Bmcneley/2027Payload/README.md

# 2027Payload
KiCad project files for 2027 Cy Launch payload PCB.
