Bmcneley/2027Payload/2027Payload.csv

Reference | Qty | Value | DNP | Exclude from BOM | Exclude from Board | Footprint | Manufacturer Part Number | Distributor Link
U12 | 1 | BMP581 |  |  |  | BMP581:BMP581 | BMP581 | https://www.digikey.com/en/products/detail/bosch-sensortec/BMP581/16036134
U11 | 1 | SAM-M10Q-00B |  |  |  | SAM-M10Q-00B:XCVR_SAM-M10Q-00B | SAM-M10Q-00B | https://www.digikey.com/en/products/detail/u-blox/SAM-M10Q-00B/16672678
U9 | 1 | TPS2113ADRBR |  |  |  | TPS2113ADRBR:SON65P300X300X100-9N | TPS2113ADRBR | https://www.digikey.com/en/products/detail/texas-instruments/TPS2113ADRBR/2353703
U7 | 1 | TLV75533PDBVR |  |  |  | TLV75533PDBVR:SOT95P280X145-5N | TLV75533PDBVR | https://www.digikey.com/en/products/detail/texas-instruments/TLV75533PDBVR/9356541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
U6 | 1 | USBLC6-2SC6 |  |  |  | Package_TO_SOT_SMD:SOT-23-6 | USBLC6-2SC6 | https://www.digikey.com/en/products/detail/stmicroelectronics/USBLC6-2SC6/1040559
U5 | 1 | BNO055 |  |  |  | BNO055:LGA28R50P4X10_380X520X100 | BNO055 | https://www.digikey.com/en/products/detail/bosch-sensortec/BNO055/6136301
U3 | 1 | TPS22965DSGT |  |  |  | TPS22965DSGT:SON50P200X200X80-9N | TPS22965DSGT | https://www.digikey.com/en/products/detail/texas-instruments/TPS22965DSGT/3661875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
U2 | 1 | TPS543620RPYR |  |  |  | TPS543620RPYR:IC_TPS543620RPYR | TPS543620RPYR | https://www.digikey.com/en/products/detail/texas-instruments/TPS543620RPYR/13563030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
U1 | 1 | ESP32-S3-WROOM-1-N8R8 |  |  |  | ESP32-S3-WROOM-1-N8R8:XCVR_ESP32S3WROOM1N8R8 | ESP32-S3-WROOM-1-N8R8 | https://www.digikey.com/en/products/detail/espressif-systems/ESP32-S3-WROOM-1-N8R8/15295891
SW1,SW2 | 2 | SW_Push |  |  |  | Button_Switch_SMD:SW_SPST_PTS645Sx43SMTR92 | PTS645SM43SMTR92 LFS | https://www.digikey.com/en/products/detail/c-k/PTS645SM43SMTR92-LFS/1146840
R34 | 1 | 90.9k |  |  |  | Resistor_SMD:R_0603_1608Metric | CR0603-FX-9092ELF | https://www.digikey.com/en/products/detail/bourns-inc/CR0603-FX-9092ELF/3784211
R31 | 1 | 300R |  |  |  | Resistor_SMD:R_0603_1608Metric | ERJ-3GEYJ301V | https://www.digikey.com/en/products/detail/panasonic-industry/ERJ-3GEYJ301V/29175
R30,R32,R33,R37 | 4 | 330R |  |  |  | Resistor_SMD:R_0603_1608Metric | RC0603FR-07330RL | https://www.digikey.com/en/products/detail/yageo/RC0603FR-07330RL/727162
R26 | 1 | 24.3k |  |  |  | Resistor_SMD:R_0603_1608Metric | RC0603FR-0724K3L | https://www.digikey.com/en/products/detail/yageo/RC0603FR-0724K3L/727078
R25 | 1 | 11.3k |  |  |  | Resistor_SMD:R_0603_1608Metric | RT0603BRD0711K3L | https://www.digikey.com/en/products/detail/yageo/RT0603BRD0711K3L/1072211
R23 | 1 | 43k |  |  |  | Resistor_SMD:R_0603_1608Metric | RC0603JR-0743KL | https://www.digikey.com/en/products/detail/yageo/RC0603JR-0743KL/726790
R21,R22,R36 | 3 | 100k |  |  |  | Resistor_SMD:R_0603_1608Metric | RC0603FR-07100KL | https://www.digikey.com/en/products/detail/yageo/RC0603FR-07100KL/726889
R16 | 1 | 91k |  |  |  | Resistor_SMD:R_0603_1608Metric | RC0603JR-0791KL | https://www.digikey.com/en/products/detail/yageo/RC0603JR-0791KL/726841
R15 | 1 | 332R |  |  |  | Resistor_SMD:R_0603_1608Metric | CR0603-FX-3320ELF | https://www.digikey.com/en/products/detail/bourns-inc/CR0603-FX-3320ELF/3783952
R10 | 1 | 100R |  |  |  | Resistor_SMD:R_0603_1608Metric | RC0603FR-07100RL | https://www.digikey.com/en/products/detail/yageo/RC0603FR-07100RL/726888
R9,R24,R27,R28,R29,R35,R38,R39,R40 | 9 | 10k |  |  |  | Resistor_SMD:R_0603_1608Metric | RC0603JR-0710KL | https://www.digikey.com/en/products/detail/yageo/RC0603JR-0710KL/726700
R7,R8 | 2 | 5.1K |  |  |  | Resistor_SMD:R_0603_1608Metric | AC0603FR-135K1L | https://www.digikey.com/en/products/detail/yageo/AC0603FR-135K1L/14008356
Q2 | 1 | AO4407A |  |  |  | AO4407A (1):SOIC127P600X175-8N | AO4407A | https://www.digikey.com/en/products/detail/alpha-omega-semiconductor-inc/AO4407A/1855794
L1 | 1 | 2.4uH |  |  |  | 744325240:WE-HCI_1050 | 744325240 | https://www.digikey.com/en/products/detail/w%C3%BCrth-elektronik/744325240/1638573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
J11 | 1 | Conn_01x03 |  |  |  | Connector_JST:JST_PH_S3B-PH-K_1x03_P2.00mm_Horizontal | B3B-PH-SM4-TBT | https://www.digikey.com/en/products/detail/jst-sales-america-inc/B3B-PH-SM4-TBT/768445?gclsrc=aw.ds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
J10 | 1 | Conn_02x03_Odd_Even |  |  |  | Connector_PinHeader_2.54mm:PinHeader_2x03_P2.54mm_Vertical | PRPC003DAAN-RC | https://www.digikey.com/en/products/detail/sullins-connector-solutions/PRPC003DAAN-RC/2775291
J8 | 1 | Conn_01x04 |  |  |  | Connector_JST:JST_PH_S4B-PH-K_1x04_P2.00mm_Horizontal | 2mm 4-pin Horizontal Connector - JST PH Compatible - 10 Pack - STEMMA | https://www.adafruit.com/product/4392
J6,J7 | 2 | Conn_01x04 |  |  |  | Connector_JST:JST_SH_SM04B-SRSS-TB_1x04-1MP_P1.00mm_Horizontal | QWIIC/STEMMAQT Connector 2mm 4pin | https://www.adafruit.com/product/4392
J3,J4,J5,J12 | 4 | Conn_01x03 |  |  |  | Connector_PinHeader_2.54mm:PinHeader_1x03_P2.54mm_Vertical | M20-9990345 | https://www.digikey.com/en/products/detail/harwin-inc/M20-9990345/3728227
J1 | 1 | USB_C_Receptacle_USB2.0_16P |  |  |  | Connector_USB:USB_C_Receptacle_GCT_USB4110 | USB4110-GF-A | https://www.digikey.com/en/products/detail/gct/USB4110-GF-A/10384547
F1 | 1 | 5A |  |  |  | Fuse:Fuse_1812_4532Metric | 0448005.MR | https://www.digikey.com/en/products/detail/littelfuse-inc/0448005-MR/1211090
D2 | 1 | 10V |  |  |  | Diode_SMD:D_SOD-123 | MMSZ5240B-7-F | https://www.digikey.com/en/products/detail/diodes-incorporated/MMSZ5240B-7-F/815879
D1 | 1 | LED |  |  |  | LED_SMD:LED_0805_2012Metric | 150080RS75000 | https://www.digikey.com/en/products/detail/w-rth-elektronik/150080RS75000/4489918?gclsrc=aw.ds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
C46 | 1 | 10n |  |  |  | Capacitor_SMD:C_0603_1608Metric | C0603C103K5RACTU | https://www.digikey.com/en/products/detail/kemet/C0603C103K5RACTU/411090
C40,C41,C44 | 3 | 22u |  |  |  | Capacitor_SMD:C_0603_1608Metric | CL10A226MO7JZNC | https://www.digikey.com/en/products/detail/samsung-electro-mechanics/CL10A226MO7JZNC/7320581
C36,C39 | 2 | 47u |  |  |  | Capacitor_SMD:C_0603_1608Metric | GRM188R60J476ME15D | https://www.digikey.com/en/products/detail/murata-electronics/GRM188R60J476ME15D/5877410
C35 | 1 | 15p |  |  |  | Capacitor_SMD:C_0603_1608Metric | CC0603JRNPO9BN150 | https://www.digikey.com/en/products/detail/yageo/CC0603JRNPO9BN150/302794
C30,C32,C33,C37,C38 | 5 | 4.7u |  |  |  | Capacitor_SMD:C_0603_1608Metric | GRM188R61E475KE11D | https://www.digikey.com/en/products/detail/murata-electronics/GRM188R61E475KE11D/3900465
C22,C42,C43,C45 | 4 | 0.1u |  |  |  | Capacitor_SMD:C_0603_1608Metric | C0603C104K5RACTU | https://www.digikey.com/en/products/detail/kemet/C0603C104K5RACTU/1465594
C18,C23,C24,C25,C26,C28,C31,C34,C47,C48,C49 | 11 | 100n |  |  |  | Capacitor_SMD:C_0603_1608Metric | C0603C104K5RACTU | https://www.digikey.com/en/products/detail/kemet/C0603C104K5RACTU/1465594
C12,C13,C15,C16,C17 | 5 | 1u |  |  |  | Capacitor_SMD:C_0603_1608Metric | UMK107AB7105KA-T | https://www.digikey.com/en/products/detail/taiyo-yuden/UMK107AB7105KA-T/3660085
C5,C14,C27,C29 | 4 | 10u |  |  |  | Capacitor_SMD:C_0603_1608Metric | GRM188R61E106MA73D | https://www.digikey.com/en/products/detail/murata-electronics/GRM188R61E106MA73D/3900497
C2 | 1 | 470u |  |  |  | Capacitor_SMD:CP_Elec_10x10 | MAL215097501E3 | https://www.digikey.com/en/products/detail/vishay-beyschlag-draloric-bc-components/MAL215097501E3/5635420
