Bmcneley/2027Payload/2027Payload.pdf

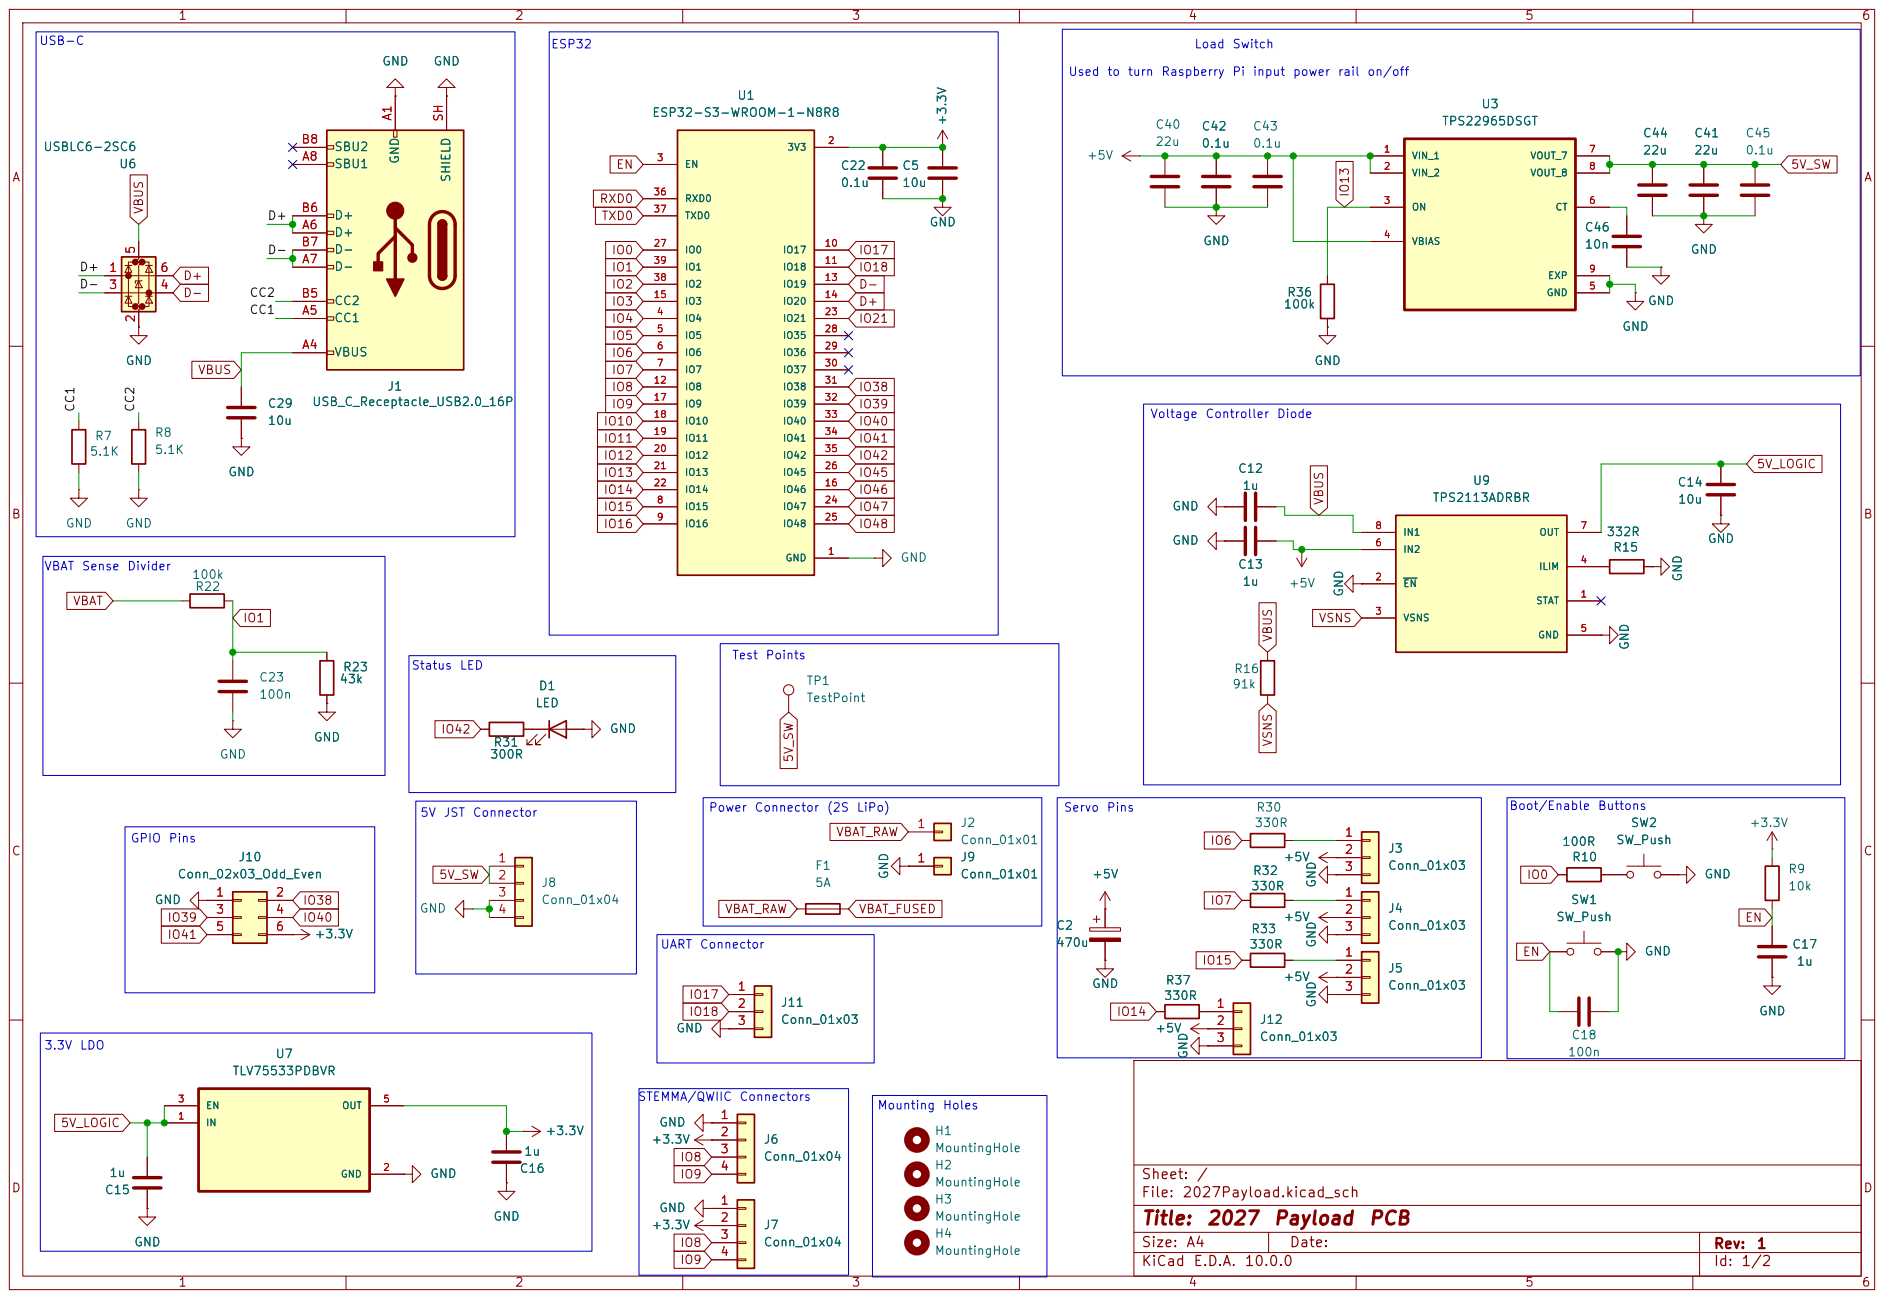
[picture p1: page 1]

Load Switch Used to turn Raspberry Pi input power rail on/off

SW_Push GND
VBAT Sense Divider GND

Boot/Enable Buttons 3.3V LDO

Size: A4 | Rev: 1
KiCad E.D.A. 10.0.0 | Id: 1/2

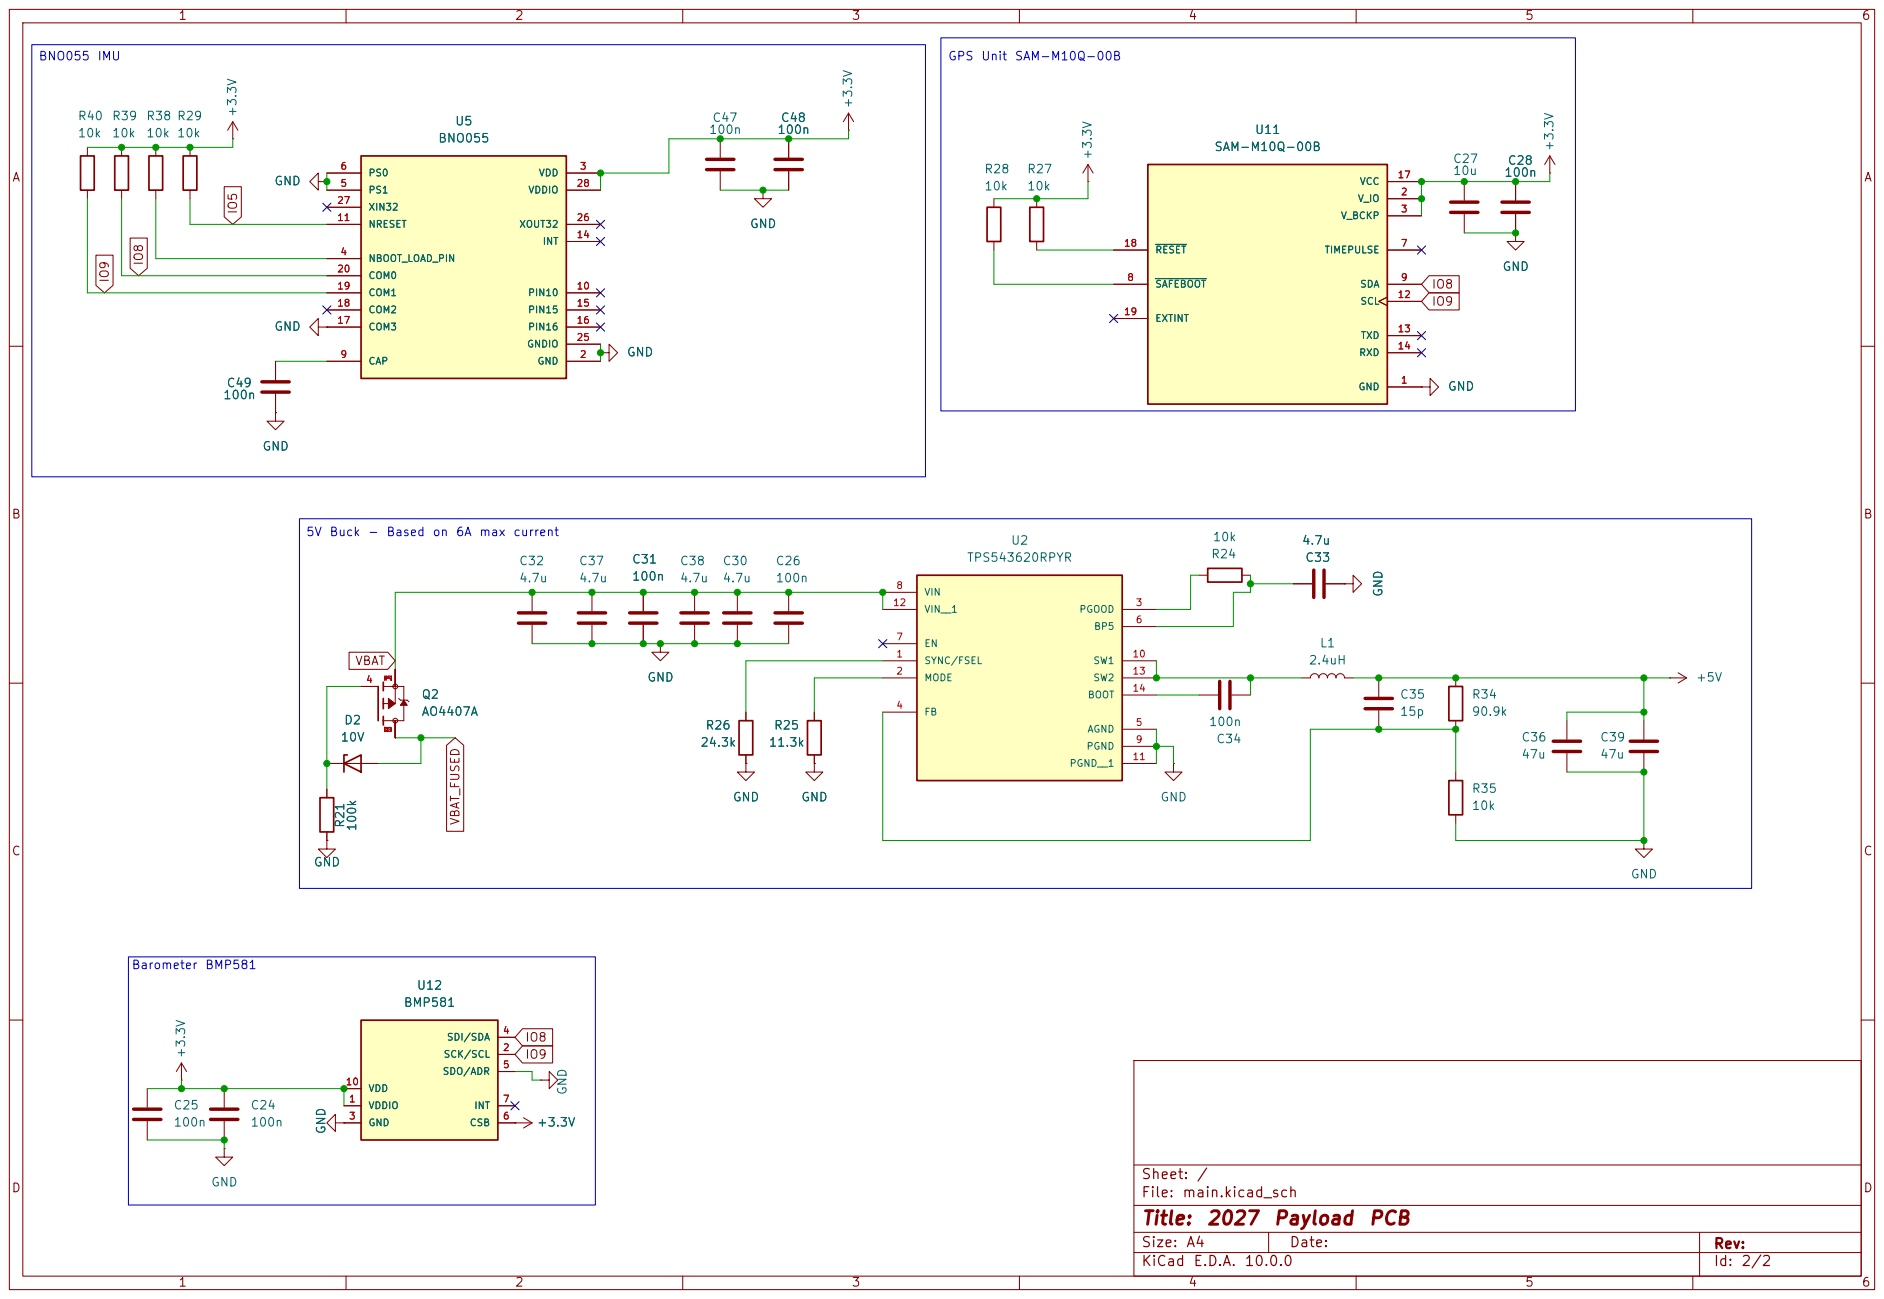
[picture p2: page 2]

Barometer BMP581

100n C25 | VDDIO 1

Size: A4 | Rev:
KiCad E.D.A. 10.0.0 | Id: 2/2
