Bmcneley/2027Payload/2027Payload.kicad_pcb

## KiCad design 2027Payload.kicad_pcb (2026-09-01)

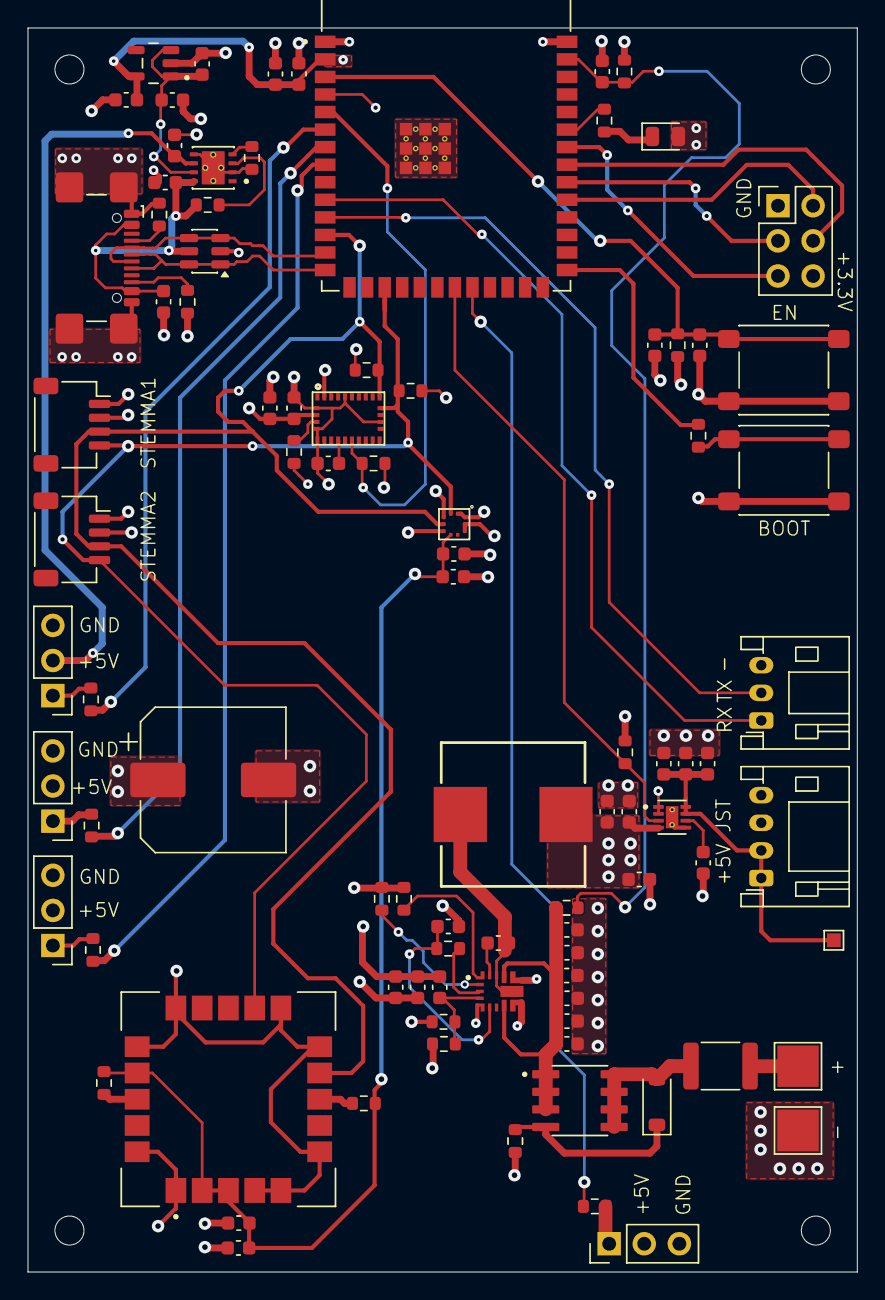
[picture p3: board 2027Payload.kicad_pcb from above]

Board: 4 copper layers, 60.0 x 90.0 mm, 96 parts (0 on the bottom side), 52 nets.

Parts:
C2: 470u; CP_Elec_10x10
C5, C14, C27, C29: 10u; C_0603_1608Metric
C12, C13, C15, C16, C17: 1u; C_0603_1608Metric
C18, C23, C24, C25, C26, C28, C31, C34, C47, C48, C49: 100n; C_0603_1608Metric
C22, C42, C43, C45: 0.1u; C_0603_1608Metric
C30, C32, C33, C37, C38: 4.7u; C_0603_1608Metric
C35: 15p; C_0603_1608Metric
C36, C39: 47u; C_0603_1608Metric
C40, C41, C44: 22u; C_0603_1608Metric
C46: 10n; C_0603_1608Metric
D1: LED; LED_0805_2012Metric
D2: 10V; D_SOD-123
F1: 5A; Fuse_1812_4532Metric
H1, H2, H3, H4: MountingHole; MountingHole_2.1mm
J1: USB_C_Receptacle_USB2.0_16P; USB_C_Receptacle_GCT_USB4110
J2, J9: Conn_01x01; TestPoint_Pad_3.0x3.0mm
J3, J4, J5, J12: Conn_01x03; PinHeader_1x03_P2.54mm_Vertical
J6, J7: Conn_01x04; JST_SH_SM04B-SRSS-TB_1x04-1MP_P1.00mm_Horizontal
J8: Conn_01x04; JST_PH_S4B-PH-K_1x04_P2.00mm_Horizontal
J10: Conn_02x03_Odd_Even; PinHeader_2x03_P2.54mm_Vertical
J11: Conn_01x03; JST_PH_S3B-PH-K_1x03_P2.00mm_Horizontal
L1: 2.4uH; WE-HCI_1050
Q2: AO4407A; SOIC127P600X175-8N
R7, R8: 5.1K; R_0603_1608Metric
R9, R24, R27, R28, R29, R35, R38, R39, R40: 10k; R_0603_1608Metric
R10: 100R; R_0603_1608Metric
R15: 332R; R_0603_1608Metric
R16: 91k; R_0603_1608Metric
R21, R22, R36: 100k; R_0603_1608Metric
R23: 43k; R_0603_1608Metric
R25: 11.3k; R_0603_1608Metric
R26: 24.3k; R_0603_1608Metric
R30, R32, R33, R37: 330R; R_0603_1608Metric
R31: 300R; R_0603_1608Metric
R34: 90.9k; R_0603_1608Metric
SW1, SW2: SW_Push; SW_SPST_PTS645Sx43SMTR92
TP1: TestPoint; TestPoint_Pad_1.0x1.0mm
U1: ESP32-S3-WROOM-1-N8R8; XCVR_ESP32S3WROOM1N8R8
U2: TPS543620RPYR; IC_TPS543620RPYR
U3: TPS22965DSGT; SON50P200X200X80-9N
U5: BNO055; LGA28R50P4X10_380X520X100
U6: USBLC6-2SC6; SOT-23-6
U7: TLV75533PDBVR; SOT95P280X145-5N
U9: TPS2113ADRBR; SON65P300X300X100-9N
U11: SAM-M10Q-00B; XCVR_SAM-M10Q-00B
U12: BMP581

Connections:
5V_LOGIC: C14.1, C15.2, U7.1 (IN), U7.3 (EN), U9.7 (OUT)
5V_SW: C41.1, C44.1, C45.1, J8.1, J8.2, TP1.1 (1_1), U3.7 (VOUT_7), U3.8 (VOUT_8)
+3.3V: C5.1, C16.2, C22.1, C24.1, C25.1, C27.1, C28.1, C47.1, C48.1, J6.2, J7.2, J10.6, R9.1, R27.1, R28.1, R29.1, R38.1, R39.1, R40.1, U1.2 (3V3), U5.3 (VDD), U5.28 (VDDIO), U7.5 (OUT), U11.2 (V_IO), U11.3 (V_BCKP), U11.17 (VCC), U12.1 (VDDIO), U12.6 (CSB), U12.10 (VDD)
+5V: C2.1, C13.1, C35.2, C36.2, C39.2, C40.1, C42.1, C43.1, J3.2, J4.2, J5.2, J12.2, L1.2, R34.2, U3.1 (VIN_1), U3.2 (VIN_2), U3.4 (VBIAS), U9.6 (IN2)
/CC1: J1.A5 (CC1), R7.1
/CC2: J1.B5 (CC2), R8.1
D+: J1.A6 (D+), J1.B6 (D+), U1.14 (IO20), U6.1 (I/O1), U6.6 (I/O1)
D-: J1.A7 (D-), J1.B7 (D-), U1.13 (IO19), U6.3 (I/O2), U6.4 (I/O2)
EN: C17.2, C18.1, R9.2, SW1.1, U1.3 (EN)
GND: C2.2, C5.2, C12.1, C13.2, C14.2, C15.1, C16.1, C17.1, C18.2, C22.2, C23.2, C24.2, C25.2, C26.2, C27.2, C28.2, C29.2, C30.2, C31.2, C32.2, C33.2, C36.1, C37.2, C38.2, C39.1, C40.2, C41.2, C42.2, C43.2, C44.2, C45.2, C46.2, C47.2, C48.2, C49.2, D1.2 (A), J1.A1 (GND), J1.A12 (GND), J1.B1 (GND), J1.B12 (GND), J1.SH (SHIELD), J3.3, J4.3, J5.3, J6.1, J7.1, J8.3, J8.4, J9.1 (Pin_1_1), J10.1, J11.3, J12.3, R7.2, R8.2, R15.2, R21.2, R23.1, R25.2, R26.2, R35.1, R36.1, SW1.2, SW2.2, U1.1 (GND), U1.40 (GND), U1.41_1 (GND), U1.41_2 (GND), U1.41_3 (GND), U1.41_4 (GND), U1.41_5 (GND), U1.41_6 (GND), U1.41_7 (GND), U1.41_8 (GND), U1.41_9 (GND), U2.5 (AGND), U2.9 (PGND), U2.11 (PGND__1), U3.5 (GND), U3.9 (EXP), U5.2 (GND), U5.5 (PS1), U5.6 (PS0), U5.17 (COM3), U5.25 (GNDIO), U6.2 (GND), U7.2 (GND), U9.2 (~EN), U9.5 (GND), U9.9 (GND), U11.1 (GND), U11.4 (GND), U11.5 (GND), U11.6 (GND), U11.10 (GND), U11.11 (GND), U11.15 (GND), U11.16 (GND), U11.20 (GND), U12.3 (GND), U12.5 (SDO/ADR), U12.8 (GND), U12.9 (GND)
IO0: R10.2, U1.27 (IO0)
IO1: C23.1, R22.2, R23.2, U1.39 (IO1)
IO5: R29.2, U1.5 (IO5), U5.11 (NRESET)
IO6: R30.2, U1.6 (IO6)
IO7: R32.2, U1.7 (IO7)
IO8: J6.3, J7.3, R39.2, U1.12 (IO8), U5.20 (COM0), U11.9 (SDA), U12.4 (SDI/SDA)
IO9: J6.4, J7.4, R40.2, U1.17 (IO9), U5.19 (COM1), U11.12 (SCL), U12.2 (SCK/SCL)
IO13: R36.2, U1.21 (IO13), U3.3 (ON)
IO14: R37.2, U1.22 (IO14)
IO15: R33.2, U1.8 (IO15)
IO17: J11.1, U1.10 (IO17)
IO18: J11.2, U1.11 (IO18)
IO38: J10.2, U1.31 (IO38)
IO39: J10.3, U1.32 (IO39)
IO40: J10.4, U1.33 (IO40)
IO41: J10.5, U1.34 (IO41)
IO42: R31.2, U1.35 (IO42)
unnamed: D1.1 (K), R31.1
unnamed: D2.1 (K), Q2.4, R21.1
unnamed: J3.1, R30.1
unnamed: J4.1, R32.1
unnamed: J5.1, R33.1
unnamed: J12.1, R37.1
unnamed: R10.1, SW2.1
unnamed: C34.1, U2.14 (BOOT)
unnamed: C33.1, R24.2, U2.6 (BP5)
unnamed: C35.1, R34.1, R35.2, U2.4 (FB)
unnamed: R25.1, U2.2 (MODE)
unnamed: R24.1, U2.3 (PGOOD)
unnamed: C34.2, L1.1, U2.10 (SW1), U2.13 (SW2)
unnamed: R26.1, U2.1 (SYNC/FSEL)
unnamed: C46.1, U3.6 (CT)
unnamed: C49.1, U5.9 (CAP)
unnamed: R38.2, U5.4 (NBOOT_LOAD_PIN)
unnamed: R15.1, U9.4 (ILIM)
unnamed: R27.2, U11.18 (~RESET)
unnamed: R28.2, U11.8 (~SAFEBOOT)
VBAT: C26.1, C30.1, C31.1, C32.1, C37.1, C38.1, Q2.1, Q2.2, Q2.3, R22.1, U2.8 (VIN), U2.12 (VIN__1)
VBAT_FUSED: D2.2 (A), F1.2, Q2.5, Q2.6, Q2.7, Q2.8
VBAT_RAW: F1.1, J2.1 (Pin_1_1)
VBUS: C12.2, C29.1, J1.A4 (VBUS), J1.A9 (VBUS), J1.B4 (VBUS), J1.B9 (VBUS), R16.2, U6.5 (VBUS), U9.8 (IN1)
VSNS: R16.1, U9.3 (VSNS)
