Bmcneley/2027Payload/(commit log)

2026-08-23 Added pins for one extra servo.
    5V, GND, IO14
    [2027Payload.kicad_pcb, 2027Payload.kicad_sch]
2026-08-23 Fabrication Outputs Rev 4
    Updated gerbers, drill files, and position files.
    ZIP can be found in Manufacturing > 2027Payload_GBR_DRL_POS_V4
    [2027Payload-B_Cu.gbr, 2027Payload-B_Mask.gbr, 2027Payload-B_Silkscreen.gbr, 2027Payload-Edge_Cuts.gbr, 2027Payload-F_Cu.gbr, 2027Payload-F_Mask.gbr, 2027Payload-F_Paste.gbr, 2027Payload-F_Silkscreen.gbr]
2026-08-23 Updated BOM
    [2027Payload.csv, 2027Payload.kicad_sch, main.kicad_sch]
2026-08-25 Final BOM
    [2027Payload.csv, 2027Payload.kicad_pcb, 2027Payload.kicad_sch, 2027PayloadBOM.xlsx, 2027Payload_BOM_LCSC.csv, 2027Payload_digikey_upload.csv, main.kicad_sch]
2026-08-25 Final BOM v2
    TI TPS543620RPYR not in stock at DigiKey; abundant stock at Mouser, so updated BOM accordingly
    [2027Payload.csv, 2027Payload.kicad_sch]
2026-09-01 BNO085 --> BNO055
    Due to stock issues, the BNO085 was changed to a BNO055.
    *Updated gerber, drill, pos files (IN ZIP FILE IN MANUFACTURING > 2027Payload_GBR_DRL_POS_V5)
    *Updated schematic and PCB design
    *Updated BOM
    *Updated canva block diagrams
    [2027Payload-B_Cu.gbr, 2027Payload-B_Mask.gbr, 2027Payload-B_Silkscreen.gbr, 2027Payload-Edge_Cuts.gbr, 2027Payload-F_Cu.gbr, 2027Payload-F_Mask.gbr, 2027Payload-F_Paste.gbr, 2027Payload-F_Silkscreen.gbr]
